wafer-space/gf180mcu-project-template/src/chip_top.sv

// SPDX-FileCopyrightText: © 2025 Project Template Contributors
// SPDX-License-Identifier: Apache-2.0

`default_nettype none

`include "generated_defines.svh"
`include "slot_defines.svh"

`ifdef SRAM_gf180mcu_ocd_ip_sram
`define gf180mcu_xxx_ip_sram__sram512x8m8wm1 gf180mcu_ocd_ip_sram__sram512x8m8wm1
`else
`define gf180mcu_xxx_ip_sram__sram512x8m8wm1 gf180mcu_fd_ip_sram__sram512x8m8wm1
`endif

`ifdef PAD_gf180mcu_ocd_io
`define gf180mcu_xxx_io__vdd gf180mcu_ocd_io__vdd
`define gf180mcu_xxx_io__vss gf180mcu_ocd_io__vss
`define gf180mcu_xxx_io__dvdd gf180mcu_ocd_io__dvdd
`define gf180mcu_xxx_io__dvss gf180mcu_ocd_io__dvss
`define gf180mcu_xxx_io__in_s gf180mcu_ocd_io__in_s
`define gf180mcu_xxx_io__in_c gf180mcu_ocd_io__in_c
`define gf180mcu_xxx_io__bi_24t gf180mcu_ocd_io__bi_24t
`define gf180mcu_xxx_io__asig_5p0 gf180mcu_ocd_io__asig_5p0
`else
`define gf180mcu_xxx_io__vdd gf180mcu_fd_io__dvdd
`define gf180mcu_xxx_io__vss gf180mcu_fd_io__dvss
`define gf180mcu_xxx_io__dvdd gf180mcu_fd_io__dvdd
`define gf180mcu_xxx_io__dvss gf180mcu_fd_io__dvss
`define gf180mcu_xxx_io__in_s gf180mcu_fd_io__in_s
`define gf180mcu_xxx_io__in_c gf180mcu_fd_io__in_c
`define gf180mcu_xxx_io__bi_24t gf180mcu_fd_io__bi_24t
`define gf180mcu_xxx_io__asig_5p0 gf180mcu_fd_io__asig_5p0
`endif

module chip_top #(
    // Power/ground pads for I/O
    parameter NUM_DVDD_PADS = `NUM_DVDD_PADS,
    parameter NUM_DVSS_PADS = `NUM_DVSS_PADS,

    // Power/ground pads for core
    parameter NUM_VDD_PADS = `NUM_VDD_PADS,
    parameter NUM_VSS_PADS = `NUM_VSS_PADS,

    // Signal pads
    parameter NUM_INPUT_PADS = `NUM_INPUT_PADS,
    parameter NUM_BIDIR_PADS = `NUM_BIDIR_PADS,
    parameter NUM_ANALOG_PADS = `NUM_ANALOG_PADS
    )(
    `ifdef USE_POWER_PINS
    inout  wire VDD,
    inout  wire VSS,
    inout  wire DVDD,
    inout  wire DVSS,
    `endif

    inout  wire clk_PAD,
    inout  wire rst_n_PAD,
    
    inout  wire [NUM_INPUT_PADS-1:0] input_PAD,
    inout  wire [NUM_BIDIR_PADS-1:0] bidir_PAD,
    
    inout  wire [NUM_ANALOG_PADS-1:0] analog_PAD
);

    wire clk_PAD2CORE;
    wire rst_n_PAD2CORE;
    
    wire [NUM_INPUT_PADS-1:0] input_PAD2CORE;
    wire [NUM_INPUT_PADS-1:0] input_CORE2PAD_PU;
    wire [NUM_INPUT_PADS-1:0] input_CORE2PAD_PD;

    wire [NUM_BIDIR_PADS-1:0] bidir_PAD2CORE;
    wire [NUM_BIDIR_PADS-1:0] bidir_CORE2PAD;
    wire [NUM_BIDIR_PADS-1:0] bidir_CORE2PAD_OE;
    wire [NUM_BIDIR_PADS-1:0] bidir_CORE2PAD_CS;
    wire [NUM_BIDIR_PADS-1:0] bidir_CORE2PAD_SL;
    wire [NUM_BIDIR_PADS-1:0] bidir_CORE2PAD_IE;
    wire [NUM_BIDIR_PADS-1:0] bidir_CORE2PAD_PU;
    wire [NUM_BIDIR_PADS-1:0] bidir_CORE2PAD_PD;

    // In the foundry pads, the I/O and
    // core voltage domains are shorted
    `ifdef USE_POWER_PINS
    `ifdef PAD_gf180mcu_fd_io
    assign VDD = DVDD;
    assign VSS = DVSS;
    `endif
    `endif

    // Power/ground pad instances
    generate
    for (genvar i=0; i<NUM_DVDD_PADS; i++) begin : dvdd_pads
        (* keep *)
        `gf180mcu_xxx_io__dvdd pad (
            `ifdef USE_POWER_PINS
            .DVDD   (DVDD),
            .DVSS   (DVSS),
            .VDD    (VDD),
            .VSS    (VSS)
            `endif
        );
    end
    for (genvar i=0; i<NUM_DVSS_PADS; i++) begin : dvss_pads
        (* keep *)
        `gf180mcu_xxx_io__dvss pad (
            `ifdef USE_POWER_PINS
            .DVDD   (DVDD),
            .DVSS   (DVSS),
            .VDD    (VDD),
            .VSS    (VSS)
            `endif
        );
    end
    for (genvar i=0; i<NUM_VDD_PADS; i++) begin : vdd_pads
        (* keep *)
        `gf180mcu_xxx_io__vdd pad (
            `ifdef USE_POWER_PINS
            .DVDD   (DVDD),
            .DVSS   (DVSS),
            .VDD    (VDD),
            .VSS    (VSS)
            `endif
        );
    end
    for (genvar i=0; i<NUM_VSS_PADS; i++) begin : vss_pads
        (* keep *)
        `gf180mcu_xxx_io__vss pad (
            `ifdef USE_POWER_PINS
            .DVDD   (DVDD),
            .DVSS   (DVSS),
            .VDD    (VDD),
            .VSS    (VSS)
            `endif
        );
    end
    endgenerate

    // Signal IO pad instances

    // Schmitt trigger
    `gf180mcu_xxx_io__in_s clk_pad (
        `ifdef USE_POWER_PINS
        .DVDD   (DVDD),
        .DVSS   (DVSS),
        .VDD    (VDD),
        .VSS    (VSS),
        `endif
    
        .Y      (clk_PAD2CORE),
        .PAD    (clk_PAD),
        
        .PU     (1'b0),
        .PD     (1'b0)
    );
    
    // Normal input
    `gf180mcu_xxx_io__in_c rst_n_pad (
        `ifdef USE_POWER_PINS
        .DVDD   (DVDD),
        .DVSS   (DVSS),
        .VDD    (VDD),
        .VSS    (VSS),
        `endif
    
        .Y      (rst_n_PAD2CORE),
        .PAD    (rst_n_PAD),
        
        .PU     (1'b0),
        .PD     (1'b0)
    );

    generate
    for (genvar i=0; i<NUM_INPUT_PADS; i++) begin : inputs
        (* keep *)
        `gf180mcu_xxx_io__in_c pad (
            `ifdef USE_POWER_PINS
            .DVDD   (DVDD),
            .DVSS   (DVSS),
            .VDD    (VDD),
            .VSS    (VSS),
            `endif
        
            .Y      (input_PAD2CORE[i]),
            .PAD    (input_PAD[i]),
            
            .PU     (input_CORE2PAD_PU[i]),
            .PD     (input_CORE2PAD_PD[i])
        );
    end
    endgenerate

    generate
    for (genvar i=0; i<NUM_BIDIR_PADS; i++) begin : bidir
        (* keep *)
        `gf180mcu_xxx_io__bi_24t pad (
            `ifdef USE_POWER_PINS
            .DVDD   (DVDD),
            .DVSS   (DVSS),
            .VDD    (VDD),
            .VSS    (VSS),
            `endif
        
            .A      (bidir_CORE2PAD[i]),
            .OE     (bidir_CORE2PAD_OE[i]),
            .Y      (bidir_PAD2CORE[i]),
            .PAD    (bidir_PAD[i]),
            
            .CS     (bidir_CORE2PAD_CS[i]),
            .SL     (bidir_CORE2PAD_SL[i]),
            .IE     (bidir_CORE2PAD_IE[i]),

            .PU     (bidir_CORE2PAD_PU[i]),
            .PD     (bidir_CORE2PAD_PD[i])
        );
    end
    endgenerate

    generate
    for (genvar i=0; i<NUM_ANALOG_PADS; i++) begin : analog
        (* keep *)
        `gf180mcu_xxx_io__asig_5p0 pad (
            `ifdef USE_POWER_PINS
            .DVDD   (DVDD),
            .DVSS   (DVSS),
            .VDD    (VDD),
            .VSS    (VSS),
            `endif
            .ASIG5V (analog_PAD[i])
        );
    end
    endgenerate

    // Core design

    chip_core #(
        .NUM_INPUT_PADS  (NUM_INPUT_PADS),
        .NUM_BIDIR_PADS  (NUM_BIDIR_PADS),
        .NUM_ANALOG_PADS (NUM_ANALOG_PADS)
    ) i_chip_core (
        `ifdef USE_POWER_PINS
        .VDD        (VDD),
        .VSS        (VSS),
        `endif
    
        .clk        (clk_PAD2CORE),
        .rst_n      (rst_n_PAD2CORE),
    
        .input_in   (input_PAD2CORE),
        .input_pu   (input_CORE2PAD_PU),
        .input_pd   (input_CORE2PAD_PD),

        .bidir_in   (bidir_PAD2CORE),
        .bidir_out  (bidir_CORE2PAD),
        .bidir_oe   (bidir_CORE2PAD_OE),
        .bidir_cs   (bidir_CORE2PAD_CS),
        .bidir_sl   (bidir_CORE2PAD_SL),
        .bidir_ie   (bidir_CORE2PAD_IE),
        .bidir_pu   (bidir_CORE2PAD_PU),
        .bidir_pd   (bidir_CORE2PAD_PD),
        
        .analog     (analog_PAD)
    );
    
    // Do not remove, necessary for tapeout
    (* keep *) gf180mcu_ws_ip__qrcode_id qrcode_id ();
    (* keep *) gf180mcu_ws_ip__shuttle_id shuttle_id ();
    (* keep *) gf180mcu_ws_ip__project_id project_id ();
    (* keep *) gf180mcu_ws_ip__marker marker ();
    
    // wafer.space logo - can be removed if desired
    (* keep *) gf180mcu_ws_ip__logo wafer_space_logo ();

endmodule

`default_nettype wire
