wafer-space/gf180mcu-project-template/(commit log)

2025-10-01 Update the flow: DRC and LVS clean
2025-10-29 Update LibreLane: add KLayout.Filler to Chip flow
2025-11-06 Reduce the clock period to prevent setup violations
    [config.yaml]
2025-11-17 fix: use gf180mcu_ws_io__dvss for the ground pads to allow connections to the PDN all around the pad ring
    [chip_top.sv]
2025-11-20 feat: pin the PDK version
2025-11-21 fix: reduce PDN macro halo
    [config.yaml]
2025-11-26 feat: Implement different slot sizes
    slot_1x1, slot_0p5x1, slot_1x0p5 and slot_0p5x0p5
2025-12-01 fix: keep hierarchy when using slang
    [config.yaml]
2025-12-01 fix: add flatglob for sram128x8
    [config.yaml]
2025-12-04 feat: enable antenna checks, update PDK to 1.3.1
2025-12-10 fix: keep fill as dummy metal, but ignore rules for Metal2
    [config.yaml]
2025-12-11 feat: do not error on magic DRC violations
    [config.yaml]
2026-03-11 chore: update to LibreLane dev (#55)
    * chore: update to LibreLane dev
    * chore: update PDK, save to final folder
    * fix: pin KLayout to 0.30.4
    [config.yaml]
2026-06-02 feat: switch to open_pdks, add 3.3V support, parallel DRC
2026-06-29 ci: print gds hash, update artifact names
